k0swe/cm108b-eval/README.md

Evaluation board for the CMedia CM108B USB audio controller.
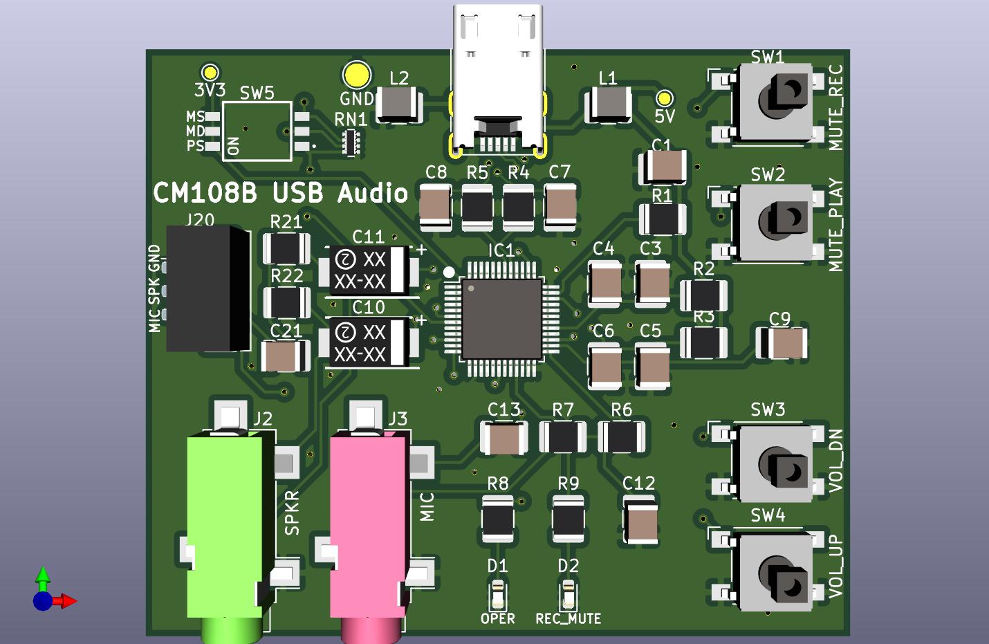
[picture p1: render.jpg]
Render
