k0swe/cm108b-eval/Datasheets/CM108 Application Notes.pdf

CM108
Integration Dual DAC, Earphone Driver, ADC, Microphone Booster, PLL, Regulator, and USB Transceiver

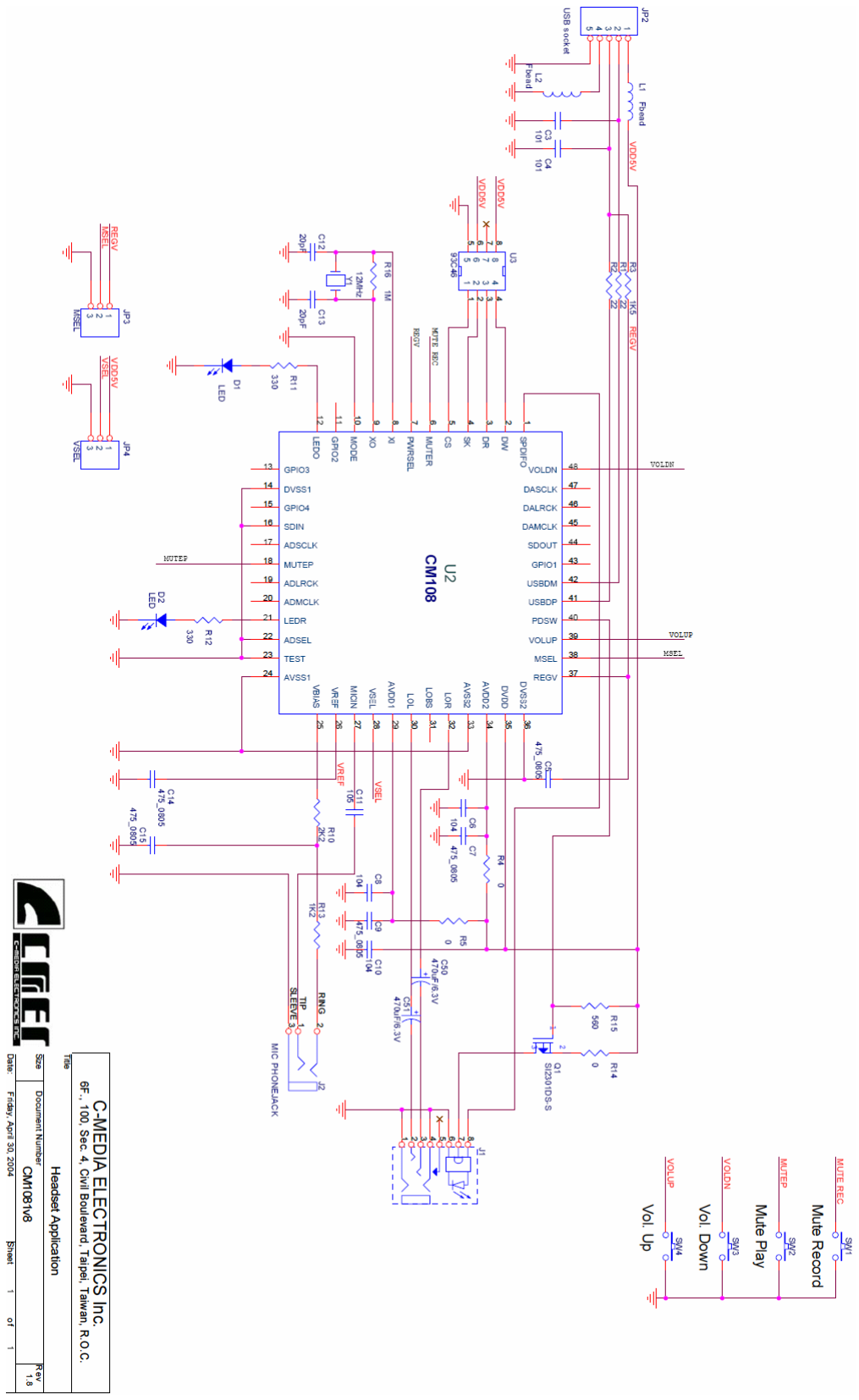
[picture p2: figure]

Date: Feb/13/2007 | Version: 1.6
- 27 -

## 10. REFERENCE APPLICATION CIRCUIT
