k0swe/cm108b-eval/cm108b-eval.pdf

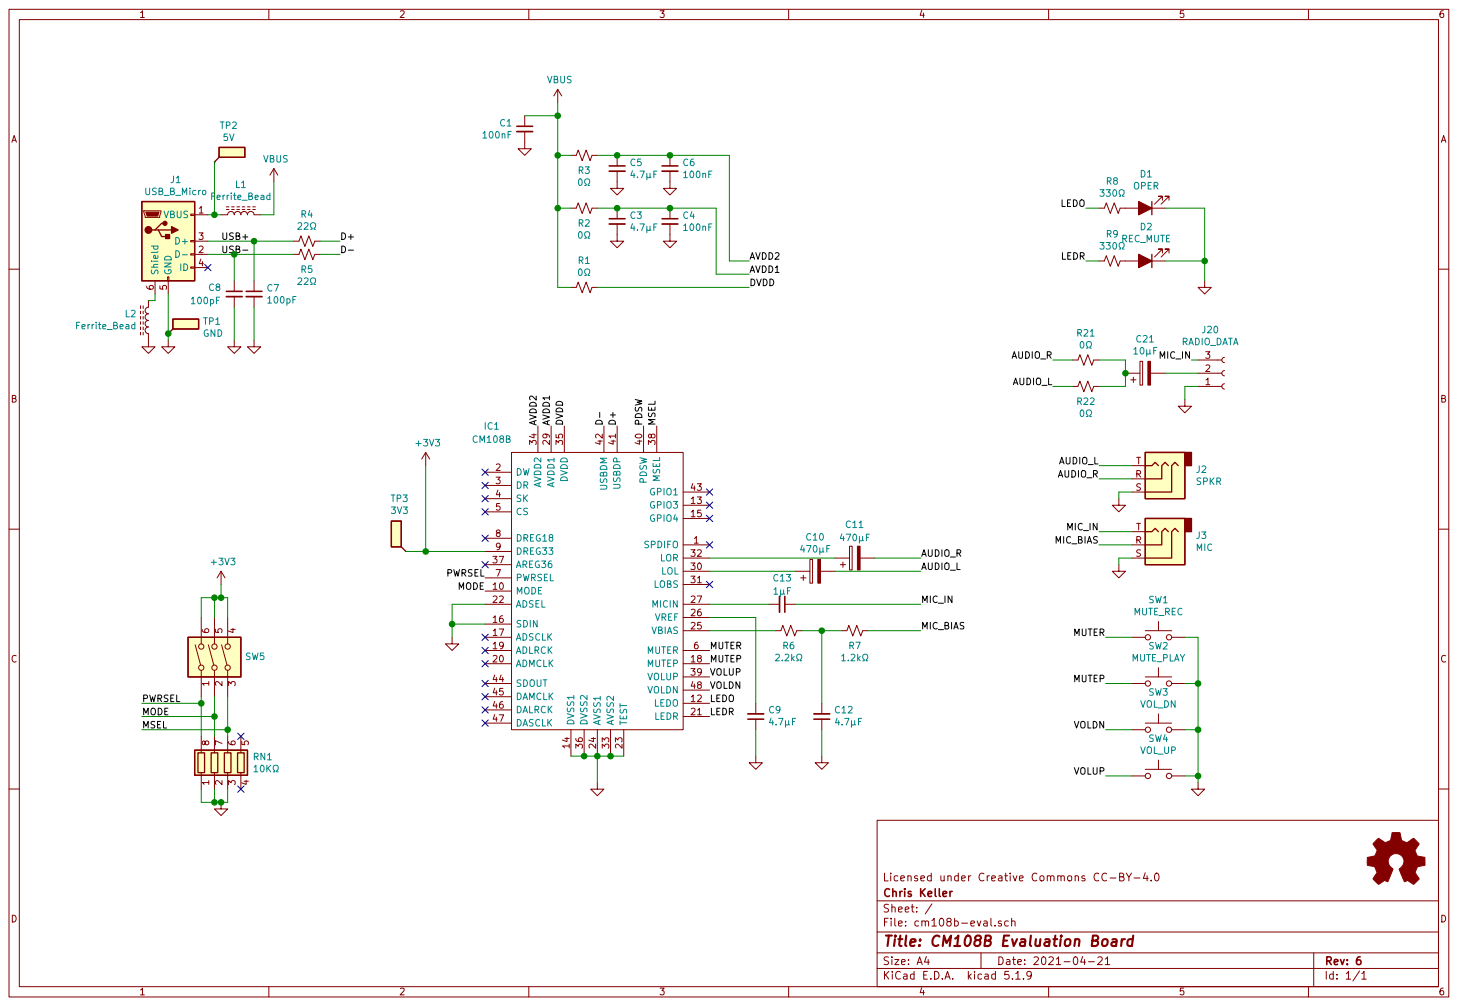
[picture p3: page 1]

Id: 1/1 Title: CM108B Evaluation Board
