k0swe/cm108b-eval/(commit log)

2021-03-22 Initial commit, WIP
    [cm108b-eval.kicad_pcb, cm108b-eval.sch]
2021-03-22 Schematic finished
    Mostly based on CM108 application note, with changes for CM108B differences. No crystal, no REGV, and I don't know what the LED in J1 is supposed to be.
    [cm108b-eval.sch]
2021-03-22 Add schematic
    [cm108b-eval.sch]
2021-03-22 Footprints assigned
    [cm108b-eval.kicad_pcb, cm108b-eval.sch]
2021-03-23 Change capacitors from exponential notation to units
    [cm108b-eval.sch]
2021-03-23 PCB laid out
    [cm108b-eval.kicad_pcb, cm108b-eval.sch]
2021-03-23 Completed BOM
    [bom.csv, cm108b-eval.kicad_pcb, cm108b-eval.sch]
2021-03-23 Move inductor to USB cable shield
    Having it on the cable's ground pin just doesn't make sense to me.
    [cm108b-eval.kicad_pcb, cm108b-eval.sch]
2021-04-03 Add some 3D models
    [cm108b-eval.kicad_pcb, cm108b-eval.sch]
2021-04-04 Convert BOM from one per line to grouped
    [bom.csv]
2021-04-05 Thicker power traces
    [cm108b-eval.kicad_pcb, cm108b-eval.sch]
2021-04-07 Fix USB connector from A to micro-B
    [cm108b-eval.kicad_pcb, cm108b-eval.sch]
2021-04-07 Couple of silkscreen improvements
    [cm108b-eval.kicad_pcb]
2021-04-14 Update micro USB part, and clean up libraries
    The Molex micro USB is nearly impossible to hand solder, so I'm moving to the CUI
    [cm108b-eval.kicad_pcb, cm108b-eval.sch]
2021-04-14 Update BOM
    [bom.csv, cm108b-eval.sch]
2021-04-15 Add CC-BY-4.0 license
    [cm108b-eval.kicad_pcb, cm108b-eval.sch]
2021-04-15 Add CUI USB 3D model
    [cm108b-eval.kicad_pcb]
2021-04-15 Add CUI phone jack 3D models
    [cm108b-eval.kicad_pcb]
2021-04-15 Add more test points
    [cm108b-eval.kicad_pcb, cm108b-eval.sch]
2021-04-15 Move 5V test point to directly off USB
    [cm108b-eval.kicad_pcb, cm108b-eval.sch]
2021-04-18 Incorporate learnings from first physical prototype
    * Button footprint pad numberings are wrong for symbol, so they were always pressed
    * Turn J3 for solderability
    [cm108b-eval.kicad_pcb, cm108b-eval.sch]
2021-04-19 Fix up BOM
    [bom.csv]
2021-04-21 Fix R and L on J1
    Resolves #1
    [cm108b-eval.kicad_pcb, cm108b-eval.sch]
2021-04-21 Copy from HS100B project to get identical layouts
    [bom.csv, cm108b-eval.kicad_pcb, cm108b-eval.sch]
2021-04-24 Add OSHW logo
    [cm108b-eval.kicad_pcb, cm108b-eval.sch]
