k0swe/cm108b-eval/(notices)

Notices in the files:
cm108b-eval.sch:
Licensed under Creative Commons CC-BY-4.0
